szymonzarosa/Echosonda-GrantRektora-KNG_Dahlta/assets/mapa3D-1.png

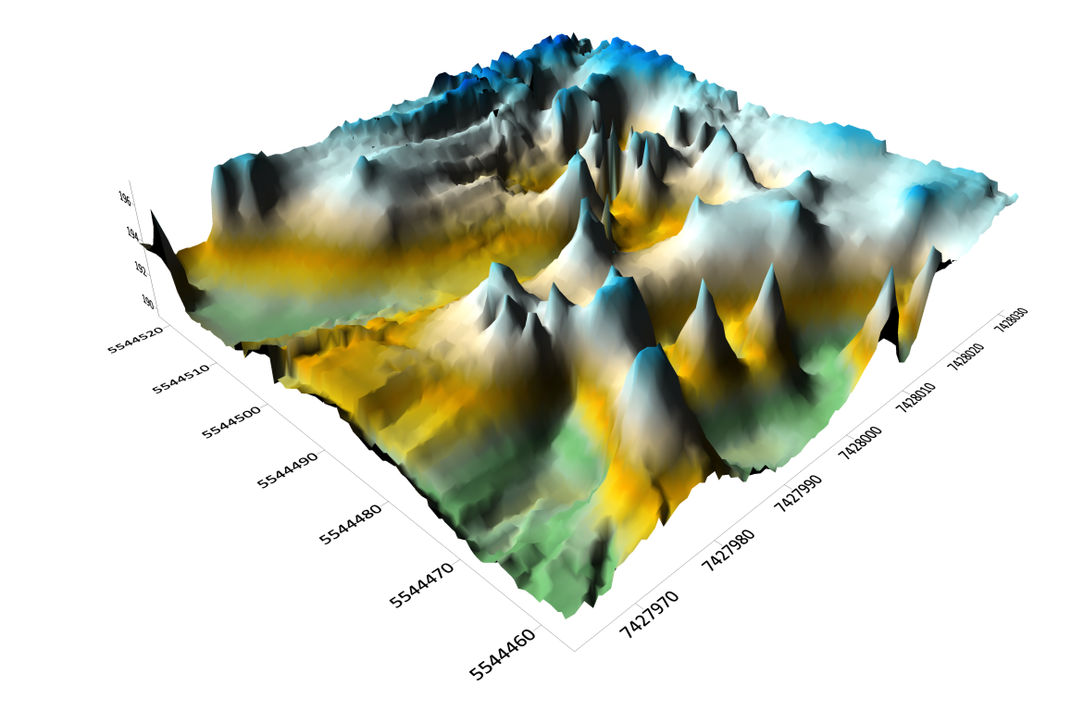
assets/mapa3D-1.png
