szymonzarosa/Echosonda-GrantRektora-KNG_Dahlta/assets/mapa3D-2.png

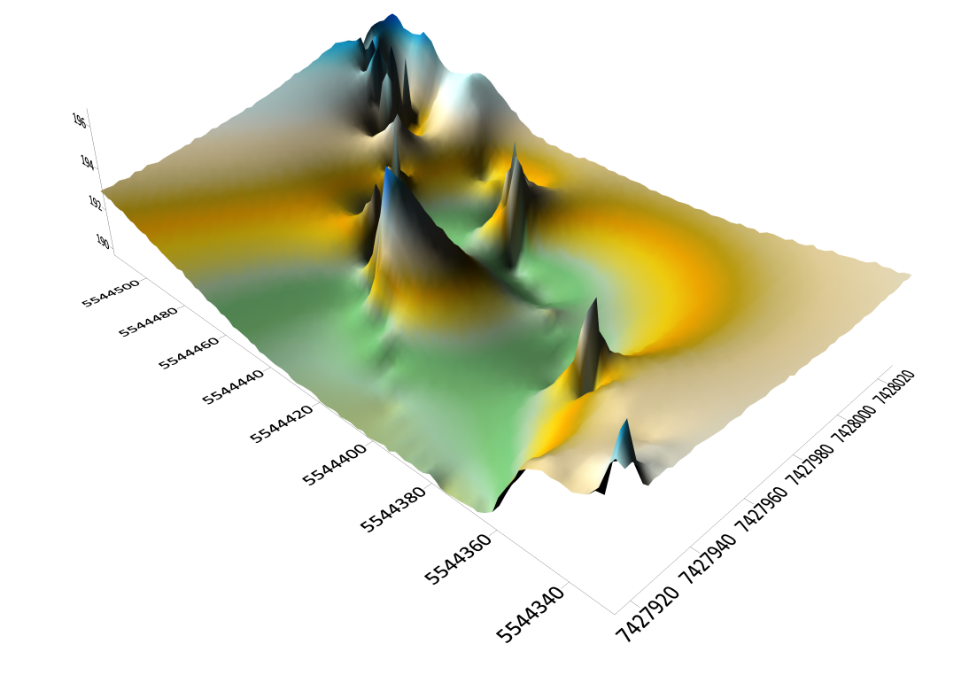
assets/mapa3D-2.png
