szymonzarosa/Echosonda-GrantRektora-KNG_Dahlta/assets/pomiar_batymetryczny_1.jpg

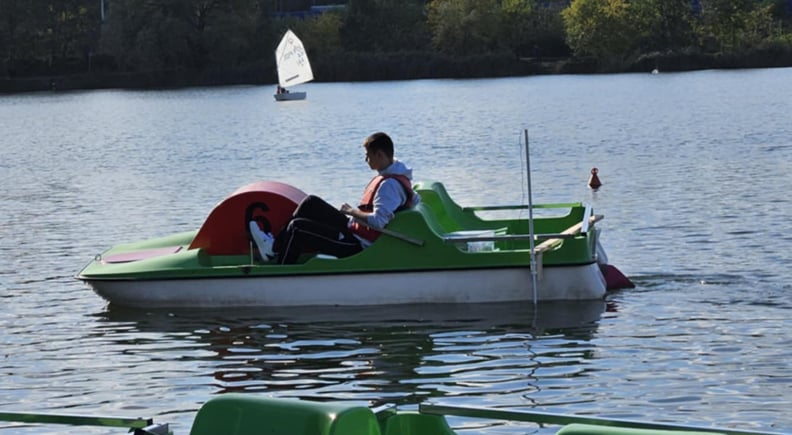
assets/pomiar_batymetryczny_1.jpg
