szymonzarosa/Echosonda-GrantRektora-KNG_Dahlta/assets/pomiar_batymetryczny_2.jpg

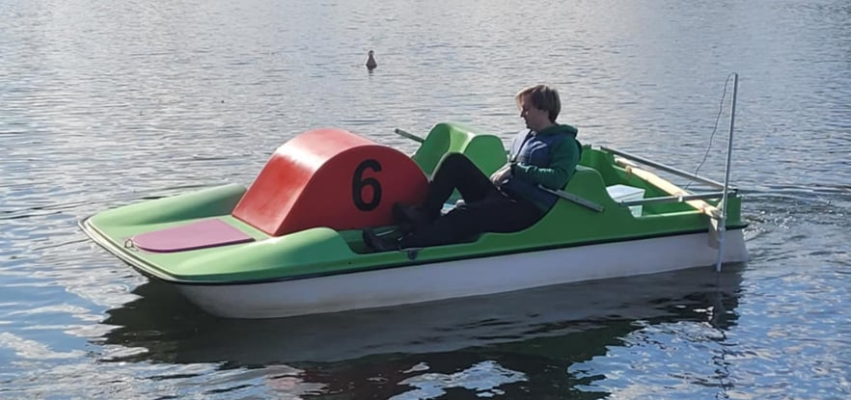
assets/pomiar_batymetryczny_2.jpg
