szymonzarosa/Echosonda-GrantRektora-KNG_Dahlta/assets/pomiar_batymetryczny_3.jpg

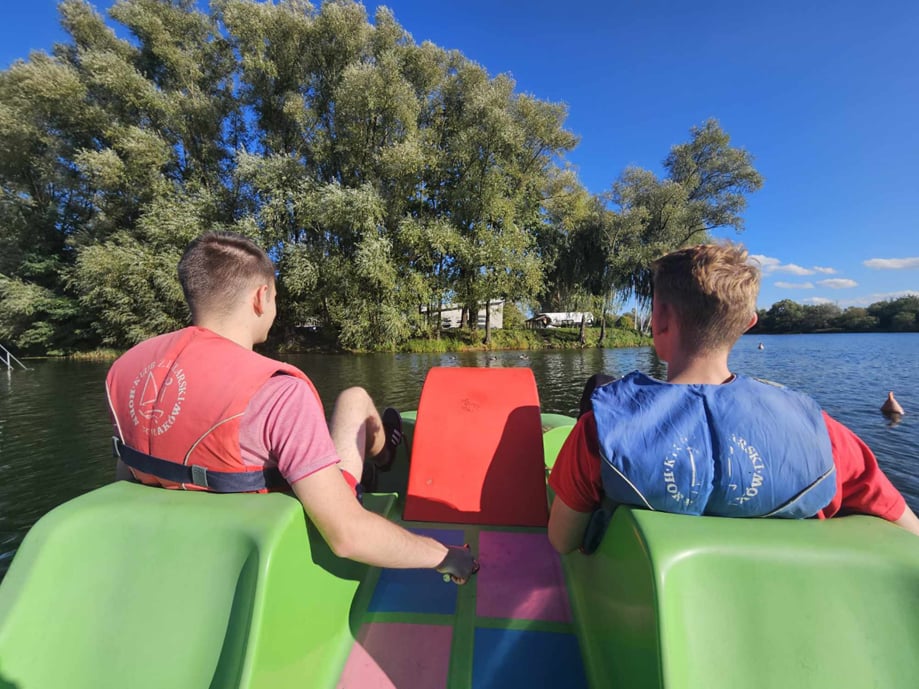
assets/pomiar_batymetryczny_3.jpg
