szymonzarosa/Echosonda-GrantRektora-KNG_Dahlta/assets/prototyp_echosondy.jpg

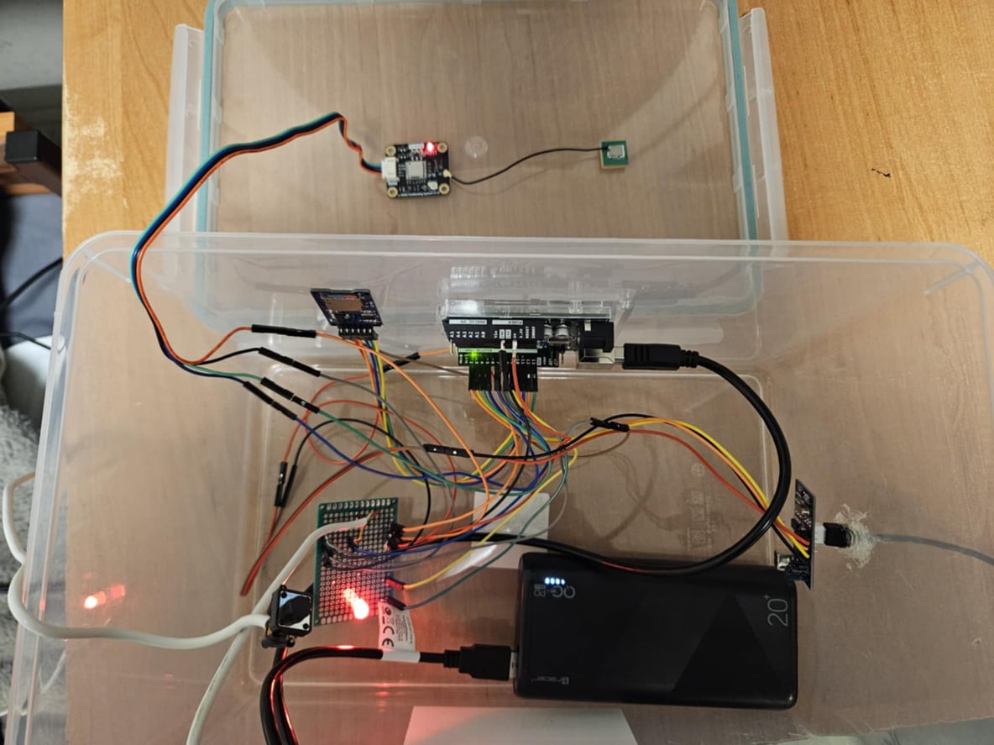
assets/prototyp_echosondy.jpg
