szymonzarosa/Echosonda-GrantRektora-KNG_Dahlta/assets/punkty_osnowy-5000-5001.jpg

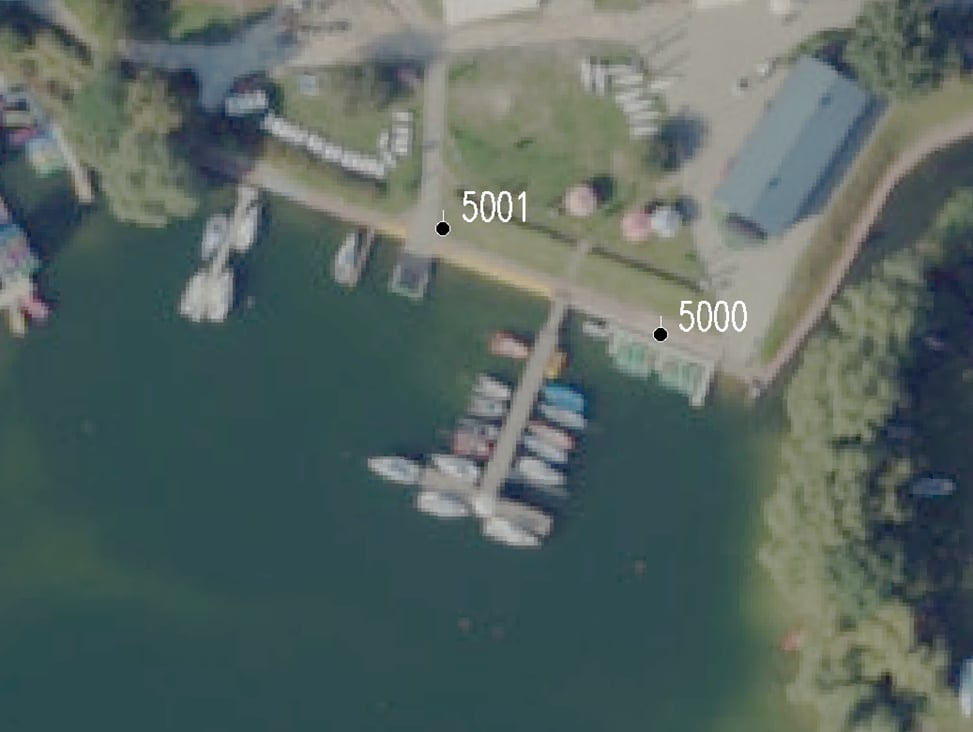
assets/punkty_osnowy-5000-5001.jpg
