szymonzarosa/Echosonda-GrantRektora-KNG_Dahlta/assets/punkty_referencyjne_wody_101_123.jpg

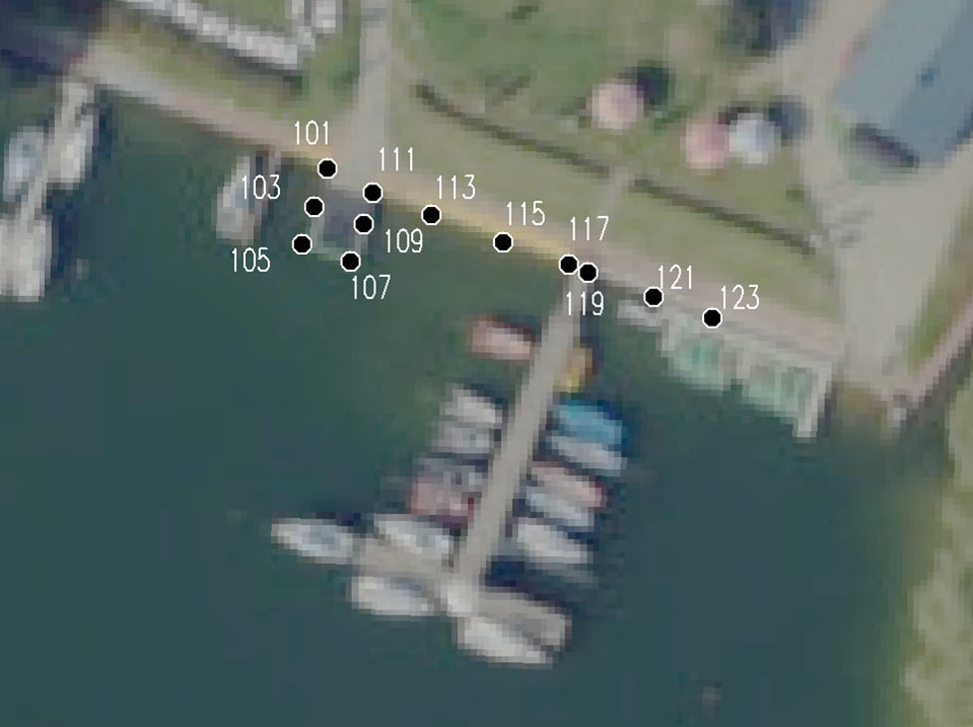
assets/punkty_referencyjne_wody_101_123.jpg
