szymonzarosa/Echosonda-GrantRektora-KNG_Dahlta/(commit log)

2024-06-24 Create ultradzwiekowy-czujnik-odleglosci-jsn-sr04t-20-450cm-z-sonda-wodoodporna
2026-01-12 refactor folder structure
    [16_2_38.CSV, 9_4_51.CSV, OSNOWA-2PUNKTY.CSV, referencja-punkty-woda.CSV]
